cgem-experiment/azimuthal_encoder/README.md

# azimuthalencoder
H7 code for azimuthal encoder sampling at 1kHz. Currently no PPS alignment. Note that v1 is the firmware currently flashed on the microcontroller in the on-site system. v2 is untested, but contains several potential improvements and catches more bugs.  

#### Latest update: Tuesday, June 10th 2025

## System overview:
- STM H723ZG microcontroller
- Hohner 20-bit absolute position encoder
- Ethernet to Fibre Media Converter
- Switch + computer

## IP settings:
- Microcontroller IP: 10.20.3.2
- Microcontroller subnet mask: 255.255.0.0
- Microcontroller gateway: 10.20.1.1
- Computer IP: 10.20.1.3
- Computer subnet mask length (on lab PC): 16
- Computer gateway (on lab PC): 10.20.1.1

## Data output from microcontroller
This section is not relevant for data analysis, see csv section below for that. 

The microcontroller sends a 602-byte UDP ethernet package consisting of 100 data samples every 10ms. One data sample is structured into 6 16-bit values follows:

MSB 16-bits of data, LSB 4-bits of data, LSB 16-bits of clock tick, MSB 16-bits of clock tick, 16-bit spacer pt.1 (0xAB89), 16-bit spacer pt. 2 (0xEFCD)

As mentioned above, there are 100 data samples in each UDP packet sent over ethernet. Thus this pattern of 6 16-bit values repeats 100 times, giving 600 bytes of data. The last two bytes of data are a 32-bit value representing the packet number (rolls over every 2^32-1). 

Note that since the 16-bit values being sent must be packaged into two 8-bit bytes, with the standard being to send the LSB first, in practice the spacer becomes 0x89ABEFCD, which is used in the python script to parse individual samples from each packet. This is also the reason the indexing in the python script for storing the data and clock tick values might seem slightly strange at first look -- it is to make sure the LSB and MSB are retrieved in the right order. 

For reference, here is a screenshot of microcontroller code to store the 6 values for one data sample in the data buffer. 
Screenshot 2024-09-09 at 10 07 25 PM

## Csv file format:
Python script saves a .csv file with the filename given in the script in the directory in which it is run from.
### | ES1 | ... | ES100 | CT1 | ... | CT100 | PN | T1 | T2 |
- ES = Encoder sample/data
- CT = Clock tick at time of querying corresponding to each encoder sample
- T1 = Real time (accurate to 1/10th of a second) when data has been received from UDP socket (added by computer)

## System diagram
Azimuthal Encoder-6

## System Pinout:
Screenshot 2024-09-05 at 4 12 59 PM

## Instructions for installation:
1. Ensure Hut PC is set to static IP 10.20.1.3 and has all IP settings above (which are what was tested in lab)
2. Connect ethernet cable between Hut PC and switch in the hut.
3. Install encoder and rotary stack.
4. Connect 5V and corresponding GND, 12V and corresponding GND, to respective linear power supplies at the telescope base. See images below. **IMPORTANT: Add GND line between the two GNDs of the linear power supplies in order to have them share a ground**. Do not plug in linear power supplies yet.
5. Connect DB15 connector to power supplies (J1) to bottom rotary stack power DB15 connector (P1).
6. Connect rotary stack power DB15 connector (J2) to box DB15 connector (P2).
7. Connect encoder connector (J3) to box connector (P3).
8. Connect optic fibre cable coming from box to top of rotary stack optic fibre (J8). Connect optic fibre cable from bottom of rotary stack to switch in hut.
9. Plug in 12V linear power supply first (this ensures that the encoder is 'on' before the microcontroller starts sending it a clock signal). Then plug in 5V linear power supply.
10. Run `setup.sh` from `az_encoder` folder. This should start a service that reads the encoder, rotating files every 30 minutes and zipping them once a day.
11. Use 'data_analysis_functions.ipynb' to help with analyzing data

## Images of in-lab setup for reference: 

### Box + Box connectors
Box + Box connectors

### Wiring of linear power supplies
Wiring of linear power supplies

### Overview of entire setup
Overview of entire setup

### Optic fibre from box connection to rotary stack
Optic fibre from box connection to rotary stack

### Optic fibre connection to switch (note L/R placement of ETH1/2)
Optic fibre connection to switch

# Firmware note:
If using v2, please note that editing in the STM32CubeIDE .ioc file may generate new task threads that are duplicates of those in USER_CODE_4.
