cgem-experiment/azimuthal_encoder/EncoderFirmwareArchitecture.jpg

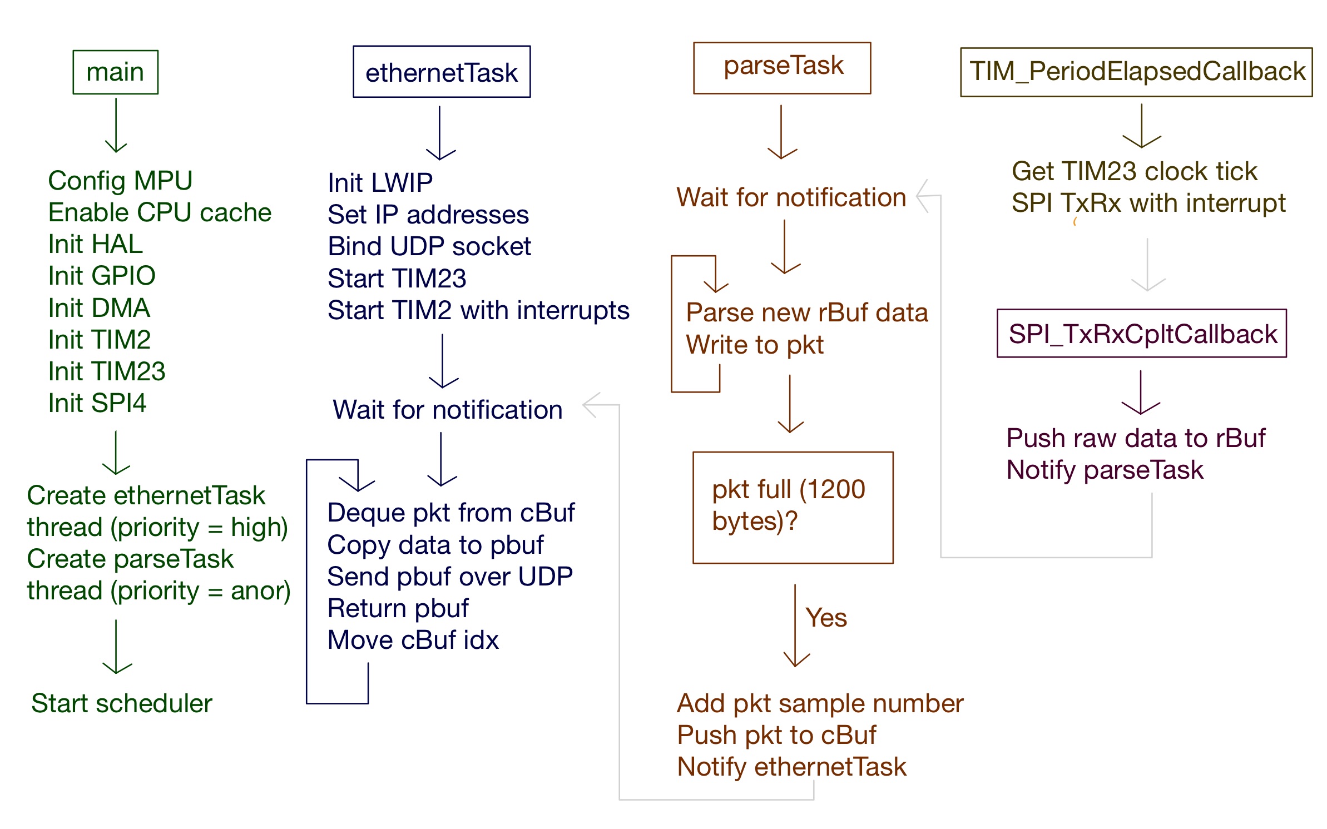
EncoderFirmwareArchitecture.jpg
