cgem-experiment/azimuthal_encoder/EncoderSystemDiagram.jpg

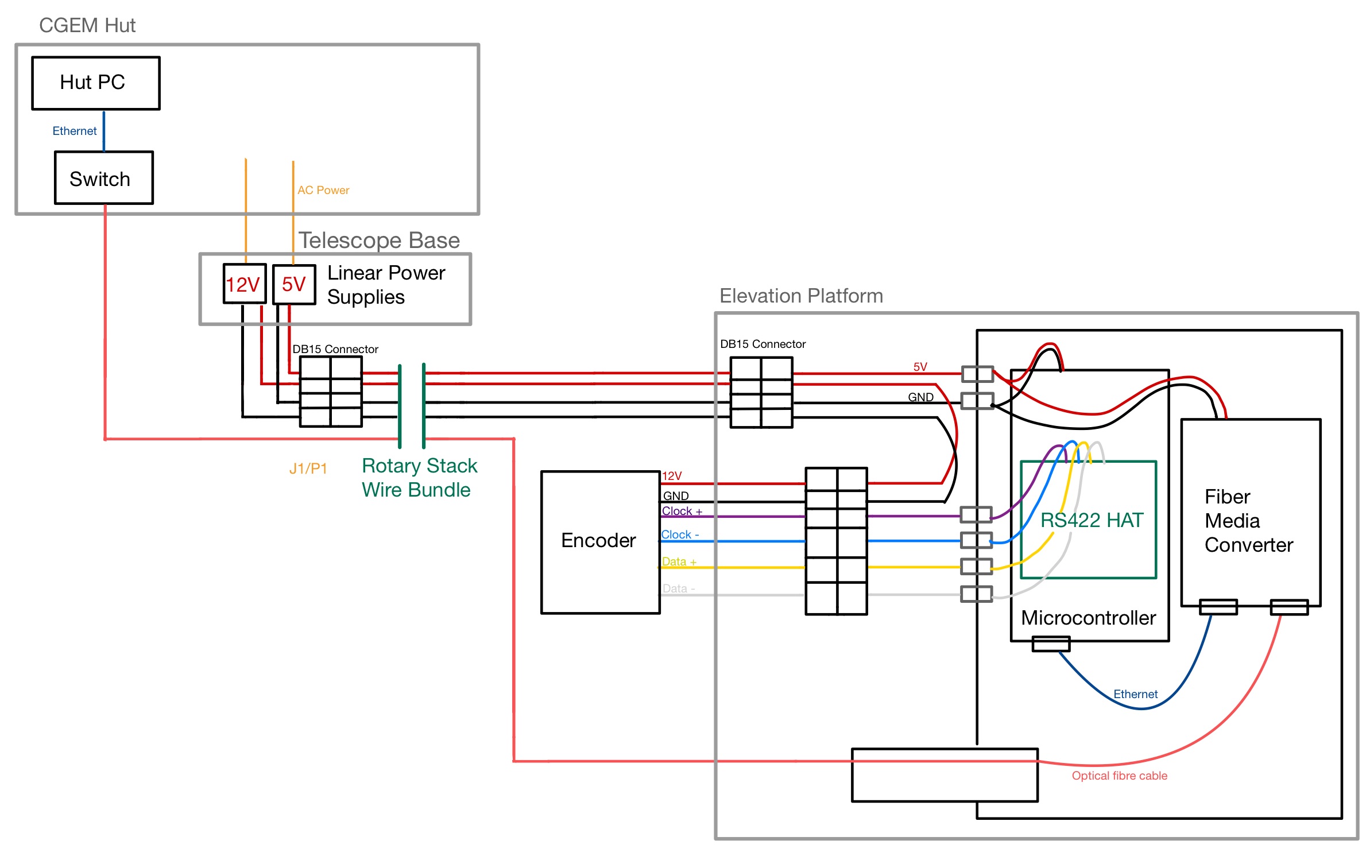
EncoderSystemDiagram.jpg
