cgem-experiment/azimuthal_encoder/EncoderBoxWiring.kicad_sch

## KiCad design EncoderBoxWiring.kicad_sch (2024-09-05)

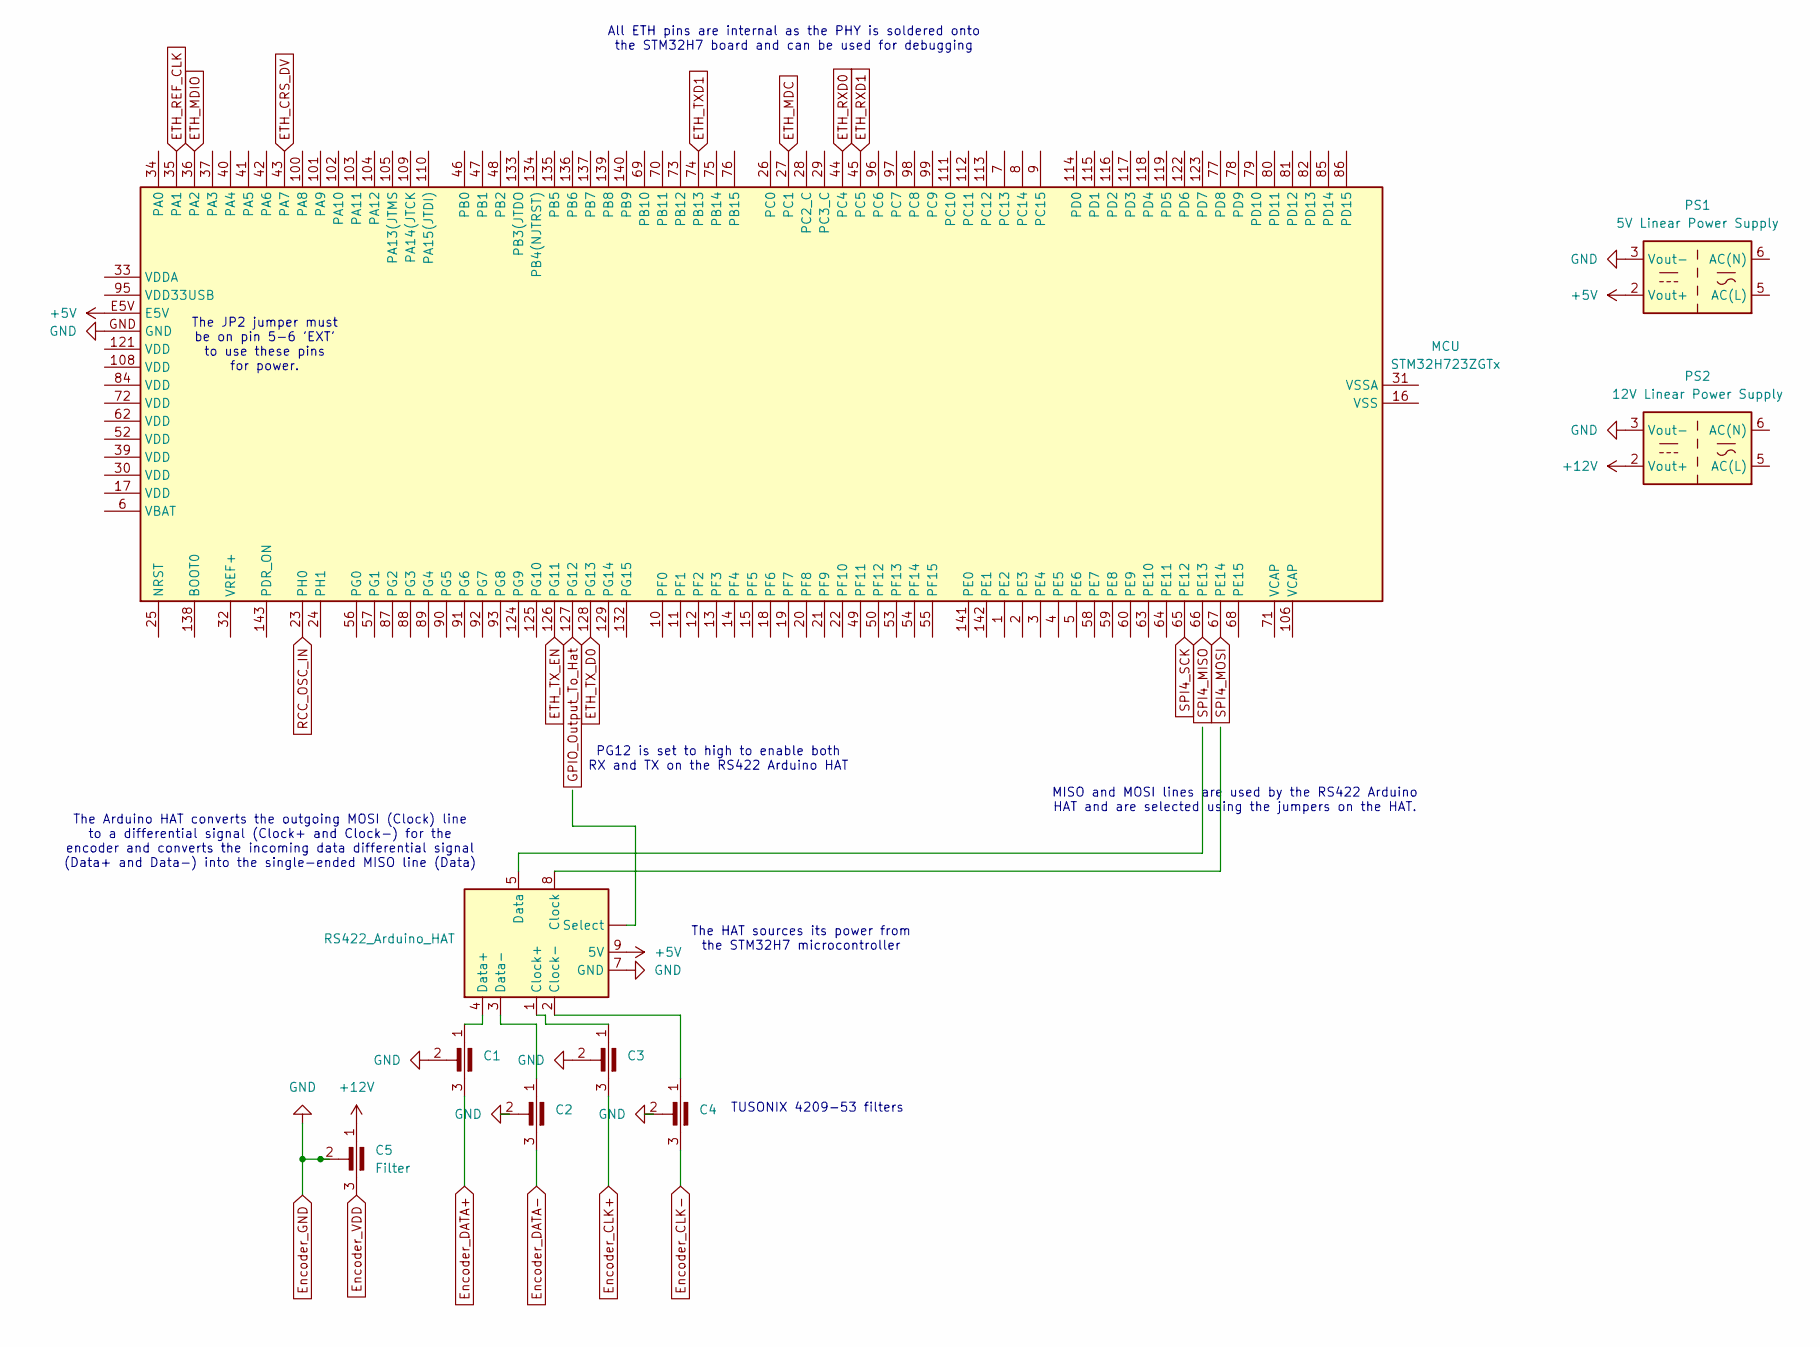
[picture p3: schematic EncoderBoxWiring.kicad_sch]

Parts:
C1, C2, C3, C4: (no value)
C5: Filter
MCU: STM32H723ZGTx; LQFP-144_20x20mm_P0.5mm
PS1: 5V Linear Power Supply; Converter_ACDC_TRACO_TMLM-04_THT
PS2: 12V Linear Power Supply; Converter_ACDC_TRACO_TMLM-04_THT
RS422_Arduino_HAT: (no value)

Connections:
+5V: MCU.E5V, PS1.2 (Vout+), RS422_Arduino_HAT.9 (5V)
+12V: C5.1, PS2.2 (Vout+)
ETH_CRS_DV: MCU.43 (PA7)
ETH_MDC: MCU.27 (PC1)
ETH_MDIO: MCU.36 (PA2)
ETH_REF_CLK: MCU.35 (PA1)
ETH_RXD0: MCU.44 (PC4)
ETH_RXD1: MCU.45 (PC5)
ETH_TXD1: MCU.74 (PB13)
ETH_TX_D0: MCU.128 (PG13)
ETH_TX_EN: MCU.126 (PG11)
Encoder_CLK+: C3.3
Encoder_CLK-: C4.3
Encoder_DATA+: C1.3
Encoder_DATA-: C2.3
Encoder_GND: C1.2, C2.2, C3.2, C4.2, C5.2, MCU.GND, PS1.3 (Vout-), PS2.3 (Vout-), RS422_Arduino_HAT.7 (GND)
Encoder_VDD: C5.3
GPIO_Output_To_Hat: MCU.127 (PG12)
unnamed: C1.1, RS422_Arduino_HAT.4 (Data+)
unnamed: C2.1, RS422_Arduino_HAT.3 (Data-)
unnamed: C3.1, RS422_Arduino_HAT.1 (Clock+)
unnamed: C4.1, RS422_Arduino_HAT.2 (Clock-)
unnamed: MCU.16 (VSS), MCU.38 (VSS), MCU.51 (VSS), MCU.61 (VSS), MCU.83 (VSS), MCU.94 (VSS), MCU.107 (VSS), MCU.120 (VSS), MCU.130 (VSS)
RCC_OSC_IN: MCU.23 (PH0)
SPI4_MISO: MCU.66 (PE13)
SPI4_MOSI: MCU.67 (PE14)
SPI4_SCK: MCU.65 (PE12)

Notes on the sheet:
The HAT sources its power from the STM32H7 microcontroller
MISO and MOSI lines are used by the RS422 Arduino HAT and are selected using the jumpers on the HAT.
The Arduino HAT converts the outgoing MOSI (Clock) line to a differential signal (Clock+ and Clock-) for the encoder and converts the incoming data differential signal (Data+ and Data-) into the single-ended MISO line (Data)
PG12 is set to high to enable both RX and TX on the RS422 Arduino HAT
All ETH pins are internal as the PHY is soldered onto the STM32H7 board and can be used for debugging
The JP2 jumper must be on pin 5-6 'EXT' to use these pins for power.
TUSONIX 4209-53 filters
