cgem-experiment/azimuthal_encoder/INSTALL.md

# Install cgem_az_encoder.py

When first installing cgem_az_encoder.py running as a service run the following commands:

- Clone this repository

- Run `/az_encoder/setup.sh` as a bash script.

All the data is to be saved in the folder `/data/`
