cgem-experiment/azimuthal_encoder/(threads)

Thread 6 (2025-05-12):

Implement Power Sequencing for the microcontroller and encoder itself

mondana, 2025-05-12:
We need to ensure that encoder (12V) is powered before the microcontroller.

Devise a power sequencing.

pedrovg99, 2025-06-10:
just realized that I am assigned to this issue? @mondana

Also, this is a duplicate from https://github.com/cgem-experiment/infrastructure/issues/152
