cgem-experiment/azimuthal_encoder/AzimuthalEncoder_v2_STM32H723ZG_CubeIDE/AZIMUTHALENCODER_H723ZG_110724/Core/Src/main.c

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
/* Includes ------------------------------------------------------------------*/
#include "main.h"
#include "cmsis_os.h"
#include "lwip.h"

/* USER CODE BEGIN Includes */
#include "lwip/udp.h"
#include <string.h>
#include <stdbool.h>
//#include "udpClientRAW.h"

/* USER CODE END Includes */


SPI_HandleTypeDef hspi4;
DMA_HandleTypeDef hdma_spi4_tx;
DMA_HandleTypeDef hdma_spi4_rx;

TIM_HandleTypeDef htim1;
TIM_HandleTypeDef htim2;
TIM_HandleTypeDef htim23;

osThreadId ethernetTaskHandle;
osThreadId  parseTaskHandle;

/* USER CODE BEGIN PV */

typedef struct {
    uint16_t raw[3]; // 3×16-bit SPI words
    uint32_t stamp; // 32-bit TIM23 snapshot
} RawSample_t;

#define RBUF_LEN 1024u // raw sample ring, making it a power of 2 makes it cheaper to modulo
#define RBUF_MASK (RBUF_LEN-1u)
static volatile RawSample_t rBuf[RBUF_LEN];
static volatile uint16_t rHead = 0, rTail = 0; // ISR = producer, parseTask = consumer

typedef struct {
    uint16_t data[601]; // one UDP payload per clean packet (601 × 16-bit = 1202 bytes)
} CleanPkt_t;

#define CBUF_LEN 4u // ready-to-send packet FIFO
#define CBUF_MASK (CBUF_LEN-1u)
static volatile CleanPkt_t cBuf[CBUF_LEN];
static volatile uint8_t cHead = 0, cTail = 0; // parseTask = producer, ethernetTask = consumer

static uint16_t pktPos = 0; // not volatile – used only in parseTask
static uint32_t sampleNum = 0; // packet counter, parseTask owned


/* USER CODE END PV */

void SystemClock_Config(void);
static void MPU_Config(void);
static void MX_GPIO_Init(void);
static void MX_DMA_Init(void);
static void MX_TIM2_Init(void);
static void MX_SPI4_Init(void);
static void MX_TIM23_Init(void);
static void MX_TIM1_Init(void);
static void startParseTask   (void const * argument);
static void startEthernetTask(void const * argument);

/* USER CODE BEGIN 0 */

static uint16_t txBuffer[3] = {0b1010101010101010, 0b1010101010101010, 0b1010101010111111};
static uint16_t rxBuffer[3];
static volatile uint32_t timer23val = 0; // Updated in TIM2 ISR

/* USER CODE END 0 */

/**
  * @brief  The application entry point.
  * @retval int
  */
int main(void)
{

  /* MPU Configuration--------------------------------------------------------*/
  MPU_Config();

  /* Enable the CPU Cache */

  /* Enable I-Cache---------------------------------------------------------*/
  SCB_EnableICache();

  /* Enable D-Cache---------------------------------------------------------*/
  SCB_EnableDCache();

  /* MCU Configuration--------------------------------------------------------*/

  /* Reset of all peripherals, Initializes the Flash interface and the Systick. */
  HAL_Init();

  /* Configure the system clock */
  SystemClock_Config();

  /* Initialize all configured peripherals */
  MX_GPIO_Init();
  MX_DMA_Init();
  MX_TIM2_Init();
  MX_SPI4_Init();
  MX_TIM23_Init();
  MX_TIM1_Init();
  /* USER CODE BEGIN 2 */

  //connect to UDP socket on computer
//  udpClient_connect();

  //start Timer 1 and 2
//  HAL_TIM_Base_Start_IT(&htim2);


  /* USER CODE END 2 */

  /* USER CODE BEGIN RTOS_MUTEX */
  /* add mutexes, ... */
  /* USER CODE END RTOS_MUTEX */

  /* USER CODE BEGIN RTOS_SEMAPHORES */
  /* add semaphores, ... */
  /* USER CODE END RTOS_SEMAPHORES */

  /* USER CODE BEGIN RTOS_TIMERS */
  /* start timers, add new ones, ... */
  /* USER CODE END RTOS_TIMERS */

  /* USER CODE BEGIN RTOS_QUEUES */
  /* add queues, ... */
  /* USER CODE END RTOS_QUEUES */

  /* Create the thread(s) */

  /* definition and creation of ethernetTask */
  osThreadDef(ethernetTask, startEthernetTask, osPriorityHigh, 0, 256);
  ethernetTaskHandle = osThreadCreate(osThread(ethernetTask), NULL);

  /* definition and creation of parseTask */
  osThreadDef(parseTask, startParseTask, osPriorityAboveNormal, 0, 512);
  parseTaskHandle = osThreadCreate(osThread(parseTask), NULL);

  /* USER CODE BEGIN RTOS_THREADS */
  /* add threads, ... */
  /* USER CODE END RTOS_THREADS */

  /* Start scheduler */
  osKernelStart();

  /* We should never get here as control is now taken by the scheduler */

  /* Infinite loop */
  /* USER CODE BEGIN WHILE */
  while (1)
  {
    /* USER CODE END WHILE */

    /* USER CODE BEGIN 3 */
  }
  /* USER CODE END 3 */
}

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
/* USER CODE BEGIN 4 */

void HAL_SPI_TxRxCpltCallback(SPI_HandleTypeDef *hspi)
{
    if (hspi->Instance == SPI4) {
        uint16_t next = (rHead + 1u) & RBUF_MASK;
        if (next != rTail) {           /* overrun protection */
            rBuf[rHead].raw[0] = rxBuffer[0];
            rBuf[rHead].raw[1] = rxBuffer[1];
            rBuf[rHead].raw[2] = rxBuffer[2];
            rBuf[rHead].stamp  = timer23val;   /* captured in TIM2 ISR */
            rHead = next;
        }
        BaseType_t hpw = pdFALSE;
        vTaskNotifyGiveFromISR(parseTaskHandle, &hpw);
        portYIELD_FROM_ISR(hpw);
    }
}

static inline uint16_t extract_value(const uint16_t *w)
{
    uint16_t v = ( ((w[0] & 0b0001000000000000) << 3) +
				  ((w[0] & 0b0000010000000000) << 4) +
				  ((w[0] & 0b0000000100000000) << 5)+
				  ((w[0] & 0b0000000001000000) << 6)+
				  ((w[0] & 0b0000000000010000) << 7)+
				  ((w[0] & 0b0000000000000100) << 8)+
				  ((w[0] & 0b0000000000000001) << 9)+
				  ((w[1] & 0b0100000000000000) >> 6) +
				  ((w[1] & 0b0001000000000000) >> 5) +
				  ((w[1] & 0b0000010000000000) >> 4) +
				  ((w[1] & 0b0000000100000000) >> 3) +
				  ((w[1] & 0b0000000001000000) >> 2) +
				  ((w[1] & 0b0000000000010000) >> 1) +
				  ((w[1] & 0b0000000000000100)     ) +
				  ((w[1] & 0b0000000000000001) << 1) +
				  ((w[2] & 0b0100000000000000) >> 14));
    return v;
}

static inline uint16_t extract_value2(const uint16_t *w)
{
	uint16_t v2 = (((w[2] & 0b0001000000000000) >> 9) +
				  ((w[2] & 0b0000010000000000) >> 8) +
				  ((w[2] & 0b0000000100000000) >> 7) +
				  ((w[2] & 0b0000000001000000) >> 6));

    return v2;
}

static void startParseTask(void const *argument)
{
    (void)argument;
    for (;;) {
        /* block until ISR gives notification */
        ulTaskNotifyTake(pdTRUE, portMAX_DELAY);

        while (rTail != rHead) {
            RawSample_t s = rBuf[rTail];
            rTail = (rTail + 1u) & RBUF_MASK;

            CleanPkt_t *pkt = (CleanPkt_t *)&cBuf[cHead];
            pkt->data[pktPos++] = extract_value(s.raw);
            pkt->data[pktPos++] = extract_value2(s.raw);
            pkt->data[pktPos++] = (uint16_t)(s.stamp);
            pkt->data[pktPos++] = (uint16_t)(s.stamp >> 16);
            pkt->data[pktPos++] = 0xAB89;
            pkt->data[pktPos++] = 0xEFCD;

            if (pktPos >= 601u) {
                pkt->data[600] = (uint16_t)sampleNum++;   /* last word = packet counter */

                uint8_t next = (cHead + 1u) & CBUF_MASK;
                if (next != cTail) {
                    pktPos = 0u;        /* reset for next packet */
                    cHead  = next;
                    xTaskNotifyGive(ethernetTaskHandle);
                } else {
                    /* ethernetTask fell behind – optional drop/flag */
                }
            }
        }
    }
}

static void startEthernetTask(void const *argument)
{
    (void)argument;
    MX_LWIP_Init();
    osDelay(100); // let LWIP be initialized

    // Own IP
	ip_addr_t myIPaddr;
	IP_ADDR4(&myIPaddr, 10, 20, 3, 2);

	// Computer IP
	ip_addr_t PC_IPADDR;
	IP_ADDR4(&PC_IPADDR, 10, 20, 1, 3);

    struct udp_pcb *pcb = udp_new();
    udp_bind(pcb, &myIPaddr, 8);
    udp_connect(pcb, &PC_IPADDR, 55151);

    struct pbuf *udp_pbuf = NULL;

    // Set PG12 to high to select 'transmit' on Arduino RS422 shield
    HAL_GPIO_WritePin(GPIOG, GPIO_PIN_12, 1);

	HAL_TIM_Base_Start(&htim23);
	HAL_TIM_Base_Start_IT(&htim2); // Start Timer 2 with 1ms interrupts

    for (;;) {
        ulTaskNotifyTake(pdTRUE, portMAX_DELAY);

        while (cTail != cHead) {
            CleanPkt_t *pkt = (CleanPkt_t *)&cBuf[cTail];

            udp_pbuf = pbuf_alloc(PBUF_TRANSPORT, sizeof(pkt->data), PBUF_RAM);
            if (udp_pbuf) {
                memcpy(udp_pbuf->payload, pkt->data, sizeof(pkt->data));
                udp_send(pcb, udp_pbuf);
                pbuf_free(udp_pbuf);
            }
            cTail = (cTail + 1u) & CBUF_MASK;
        }
    }
}

/* USER CODE END 4 */

 /* MPU Configuration */

void MPU_Config(void)
{
  MPU_Region_InitTypeDef MPU_InitStruct = {0};

  /* Disables the MPU */
  HAL_MPU_Disable();

  /** Initializes and configures the Region and the memory to be protected
  */
  MPU_InitStruct.Enable = MPU_REGION_ENABLE;
  MPU_InitStruct.Number = MPU_REGION_NUMBER0;
  MPU_InitStruct.BaseAddress = 0x0;
  MPU_InitStruct.Size = MPU_REGION_SIZE_4GB;
  MPU_InitStruct.SubRegionDisable = 0x87;
  MPU_InitStruct.TypeExtField = MPU_TEX_LEVEL0;
  MPU_InitStruct.AccessPermission = MPU_REGION_NO_ACCESS;
  MPU_InitStruct.DisableExec = MPU_INSTRUCTION_ACCESS_DISABLE;
  MPU_InitStruct.IsShareable = MPU_ACCESS_SHAREABLE;
  MPU_InitStruct.IsCacheable = MPU_ACCESS_NOT_CACHEABLE;
  MPU_InitStruct.IsBufferable = MPU_ACCESS_NOT_BUFFERABLE;

  HAL_MPU_ConfigRegion(&MPU_InitStruct);

  /** Initializes and configures the Region and the memory to be protected
  */
  MPU_InitStruct.Number = MPU_REGION_NUMBER1;
  MPU_InitStruct.BaseAddress = 0x30000000;
  MPU_InitStruct.Size = MPU_REGION_SIZE_1KB;
  MPU_InitStruct.SubRegionDisable = 0x0;
  MPU_InitStruct.AccessPermission = MPU_REGION_FULL_ACCESS;
  MPU_InitStruct.IsBufferable = MPU_ACCESS_BUFFERABLE;

  HAL_MPU_ConfigRegion(&MPU_InitStruct);

  /** Initializes and configures the Region and the memory to be protected
  */
  MPU_InitStruct.Number = MPU_REGION_NUMBER2;
  MPU_InitStruct.BaseAddress = 0x30000200;
  MPU_InitStruct.Size = MPU_REGION_SIZE_64KB;
  MPU_InitStruct.TypeExtField = MPU_TEX_LEVEL1;
  MPU_InitStruct.IsShareable = MPU_ACCESS_NOT_SHAREABLE;
  MPU_InitStruct.IsBufferable = MPU_ACCESS_NOT_BUFFERABLE;

  HAL_MPU_ConfigRegion(&MPU_InitStruct);
  /* Enables the MPU */
  HAL_MPU_Enable(MPU_PRIVILEGED_DEFAULT);

}

/**
  * @brief  Period elapsed callback in non blocking mode
  * @note   This function is called  when TIM6 interrupt took place, inside
  * HAL_TIM_IRQHandler(). It makes a direct call to HAL_IncTick() to increment
  * a global variable "uwTick" used as application time base.
  * @param  htim : TIM handle
  * @retval None
  */
void HAL_TIM_PeriodElapsedCallback(TIM_HandleTypeDef *htim)
{
  if (htim->Instance == TIM6) {
    HAL_IncTick();
  }
  /* USER CODE BEGIN Callback 1 */

  if (htim->Instance == TIM2) {
	  timer23val = __HAL_TIM_GET_COUNTER(&htim23);
	  HAL_SPI_TransmitReceive_IT(&hspi4, (uint8_t *)txBuffer, (uint8_t *)rxBuffer, 3);
  }

  /* USER CODE END Callback 1 */
}

/**
  * @brief  This function is executed in case of error occurrence.
  * @retval None
  */
void Error_Handler(void)
{
  /* USER CODE BEGIN Error_Handler_Debug */
  /* User can add his own implementation to report the HAL error return state */
  __disable_irq();
  while (1)
  {
  }
  /* USER CODE END Error_Handler_Debug */
}

#ifdef  USE_FULL_ASSERT
/**
  * @brief  Reports the name of the source file and the source line number
  *         where the assert_param error has occurred.
  * @param  file: pointer to the source file name
  * @param  line: assert_param error line source number
  * @retval None
  */
void assert_failed(uint8_t *file, uint32_t line)
{
  /* USER CODE BEGIN 6 */
  /* User can add his own implementation to report the file name and line number,
     ex: printf("Wrong parameters value: file %s on line %d\r\n", file, line) */
  /* USER CODE END 6 */
}
#endif /* USE_FULL_ASSERT */
