cgem-experiment/azimuthal_encoder/AzimuthalEncoder_v1_STM32H723ZG_CubeIDE/AZIMUTHALENCODER_H723ZG_110724/AZIMUTHALENCODER_H723ZG_110724.ioc

Mcu.UserName=STM32H723ZGTx
PA1.Signal=ETH_REF_CLK
PA2.Signal=ETH_MDIO
PA7.Signal=ETH_CRS_DV
PB13.Signal=ETH_TXD1
PC1.Signal=ETH_MDC
PC4.Signal=ETH_RXD0
PC5.Signal=ETH_RXD1
PE12.Signal=SPI4_SCK
PE13.Signal=SPI4_MISO
PE14.Signal=SPI4_MOSI
PG11.Signal=ETH_TX_EN
PG12.Signal=GPIO_Output
PG13.Signal=ETH_TXD0
PH0-OSC_IN.Signal=RCC_OSC_IN
