cgem-experiment/azimuthal_encoder/(commit log)

2024-09-05 Added pin-level schematic of wiring
    [EncoderBoxWiring.kicad_sch]
2024-09-26 Edited print statements
2024-12-11 Create cgem_az_encoder.py
    Updated the encoder to incoporate a rotating handling of files (at half past and at o'clock a new encoder file is created and written to), a logger and new error handling
2025-01-14 Added python service for reading the encoder
2025-06-09 fix(cgem_az_encoder.py): removed stale function to zip encoder file
    Remove a leftover functionality that attempted to zip encoder files every day after midnight.
2025-06-09 fix(cgem_az_encoder.py): fix timing in the encoder readout
    Timestamp encoder data upon reception
2025-06-10 fix(cgem_az_encoder.py): removed stale function to zip encoder file
2025-06-10 doc(README.md): update README file to encoder timing fix
2025-06-10 fix(cgem_az_encoder.py): fix timing in the encoder readout
