cgem-experiment/azimuthal_encoder/(notices)

Notices in the files:
AzimuthalEncoder_v2_STM32H723ZG_CubeIDE/AZIMUTHALENCODER_H723ZG_110724/Core/Src/main.c:
Copyright (c) 2024 STMicroelectronics.
All rights reserved.
This software is licensed under terms that can be found in the LICENSE file
